arvndlr/air-quality-app/.codex-remote-attachments/019ea0f2-240d-7be0-9d85-20d7ddeb425b/a20465ec-c1ca-47cc-bcd7-c16e4f965e72/1-Photo-1.jpg

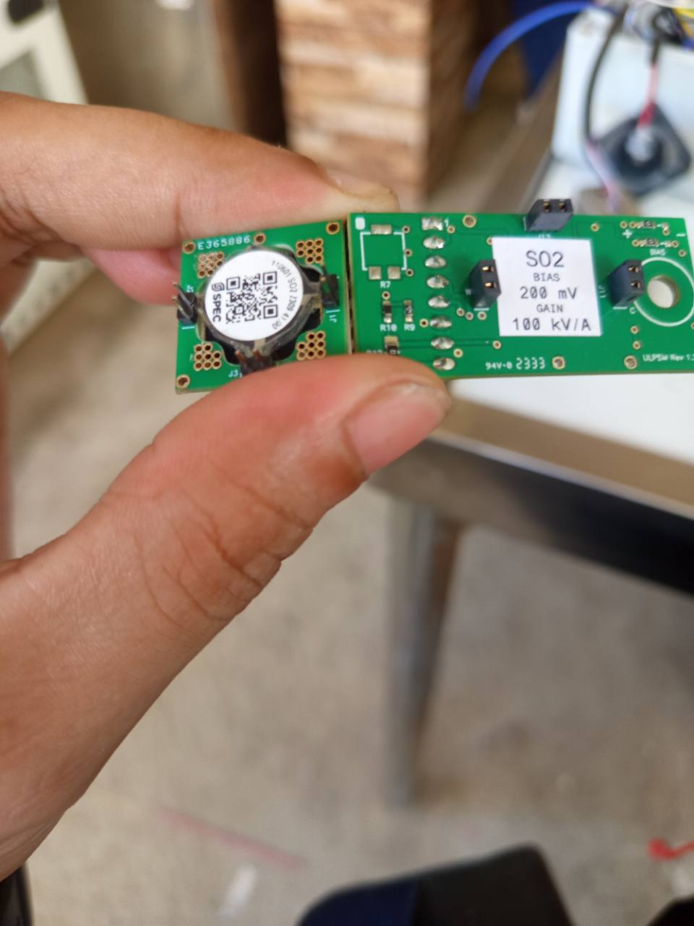
.codex-remote-attachments/019ea0f2-240d-7be0-9d85-20d7ddeb425b/a20465ec-c1ca-47cc-bcd7-c16e4f965e72/1-Photo-1.jpg
