arvndlr/air-quality-app/docs/app-flowchart-a4.pdf

# Air Quality App Flowchart

Single-page A4 layout based on the diagrams defined in docs/app-flowchart.md. | A4 Landscape

# 1. End-to-End System Flow

No | Yes
No | Yes

## ESP32 boots

## Initialize sensors and hardware BME680, SCD40, PM, SO2, MiCS-6814, battery relay

## Connect Wi-Fi and sync time

## Warm up and calibrate sensors MiCS baseline, SO2 warmup/baseline

## Main loop every 10s

## Read sensors and system state

## Compute derived values VOC index, SO2 ppb, CO/NO2/NH3 estimates

## Build telemetry JSON payload

## Wi-Fi connected?

Store payload in offline ring buffer | Flush buffered payloads first

## POST /api/v1/ingest with X-API-Key

## API validates body with Zod

## Find device by externalId

## Device found and API key valid?

Return 404 or 401 | Create Measurement row in PostgreSQL via Prisma

## Compute AQI from PM2.5, PM10, CO, NO2, SO2

## Publish measurement over WebSocket hub

Return 201 OK | Dashboard WebSocket clients /ws?deviceId=... or all

## Historical data available to REST endpoints

# 2. Web App Navigation and Data Flow

/

/admin/login

No | Yes

/admin/*

No | Yes

User opens web app

Route

Landing Page

Admin Login link

Admin Login

Valid email and password
length?
Show client-side error | Save admin session in sessionStorage

Redirect to requested /admin route

RequireAdminAuth

Session exists?

AdminLayout + Sidebar

AQI Dashboard | Sensor Nodes | Pollutant Info | Transmission History | Admin Reports | Placeholder pages FAQs, About, Terms, Settings
listDevices | getLatest for selected device
getSeries for selected metric/range | Open WebSocket for selected device

On live measurement message update latest reading and AQI card

listDevices

getLatest for each device

Static AQI and pollutant guidance content

listDevices | getTransmissionHistory device/range/status/page filters
listDevices | getTransmissionHistory
for report window
getLatest for selected/all devices | window.print for printable report

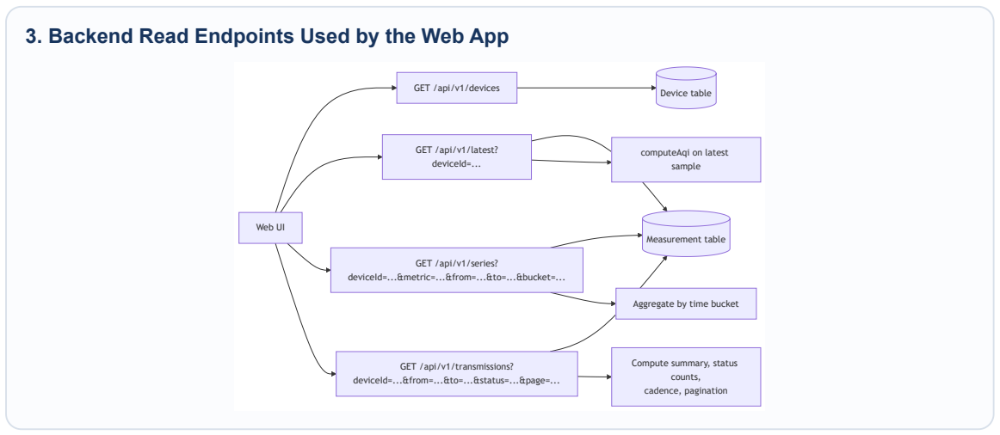
[picture p2: figure]
Web UI; GET /api/v1/devices; GET /api/v1/latest? deviceId=...; Device table; Measurement table; computeAqi on latest sample; Aggregate by time bucket; Compute summary, status counts, cadence, pagination

# 3. Backend Read Endpoints Used by the Web App

GET /api/v1/series? deviceId=...&metric=...&from=...&to=...&bucket=...

GET /api/v1/transmissions? deviceId=...&from=...&to=...&status=...&page=...
