arvndlr/air-quality-app/docs/app-flowchart-reference-style.docx

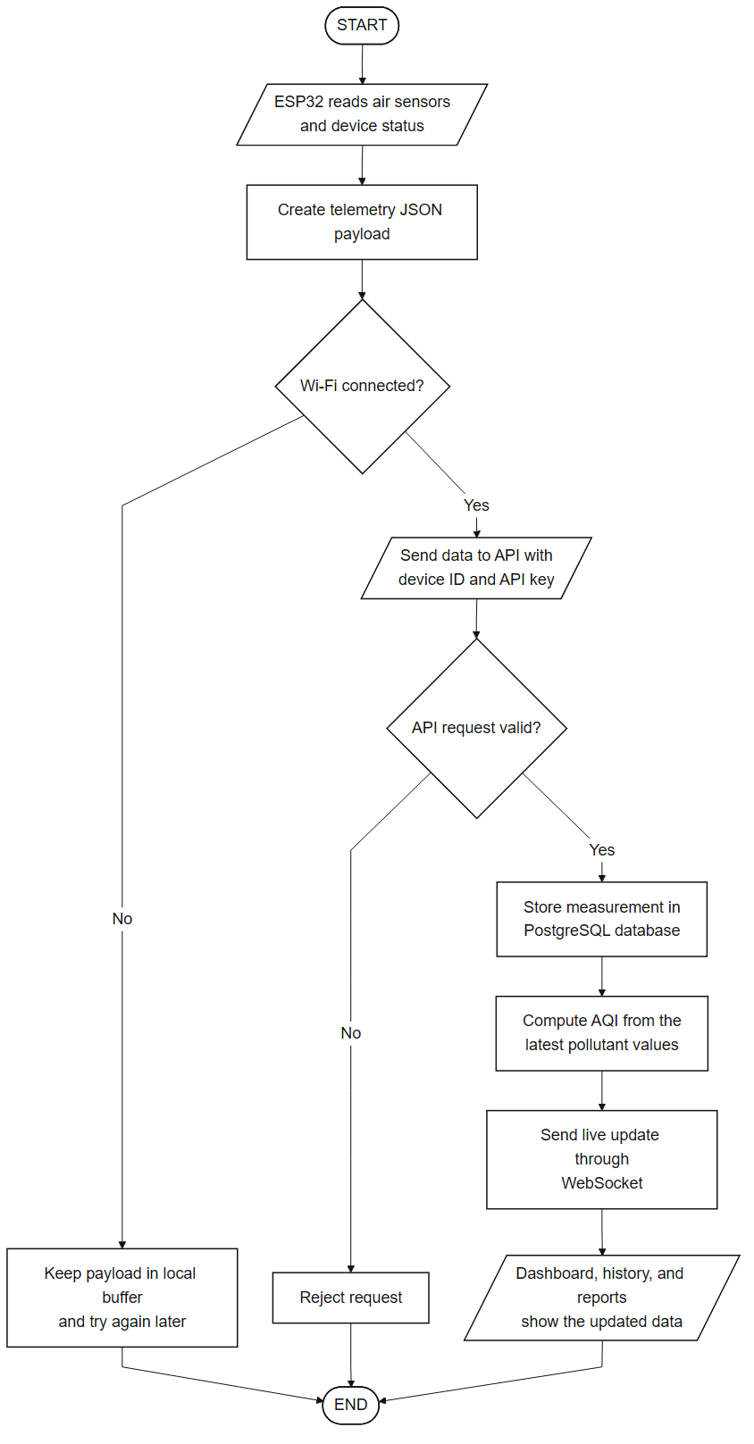
[picture p3: figure]
