arvndlr/air-quality-app/docs/app-flowchart-a4.jpg

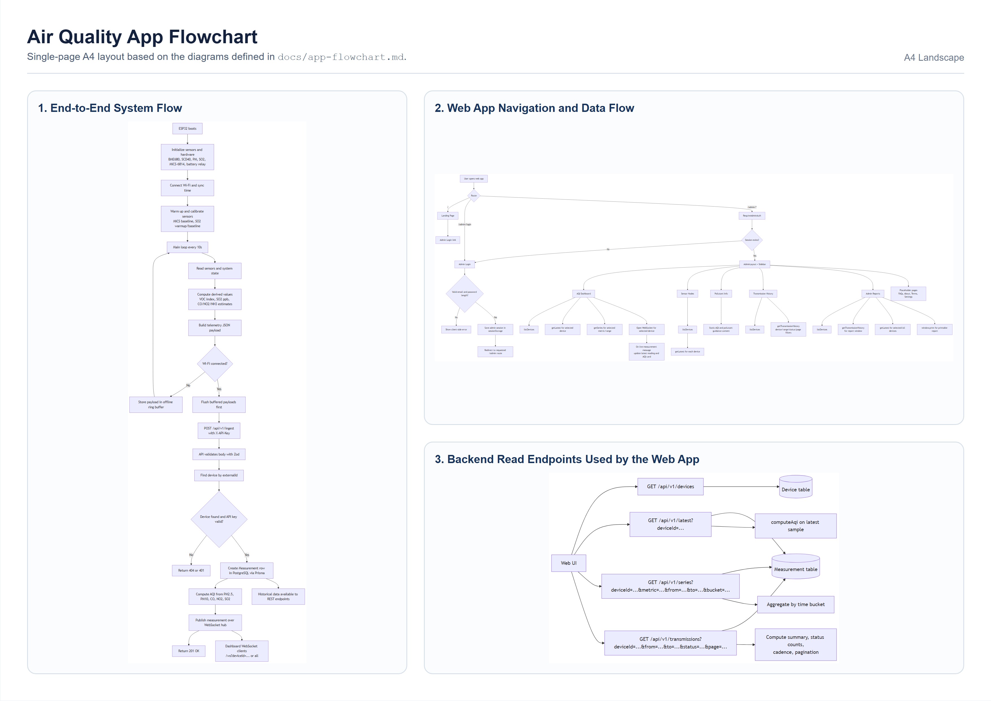
docs/app-flowchart-a4.jpg
