arvndlr/air-quality-app/docs/app-flowchart-backend-a4.jpg

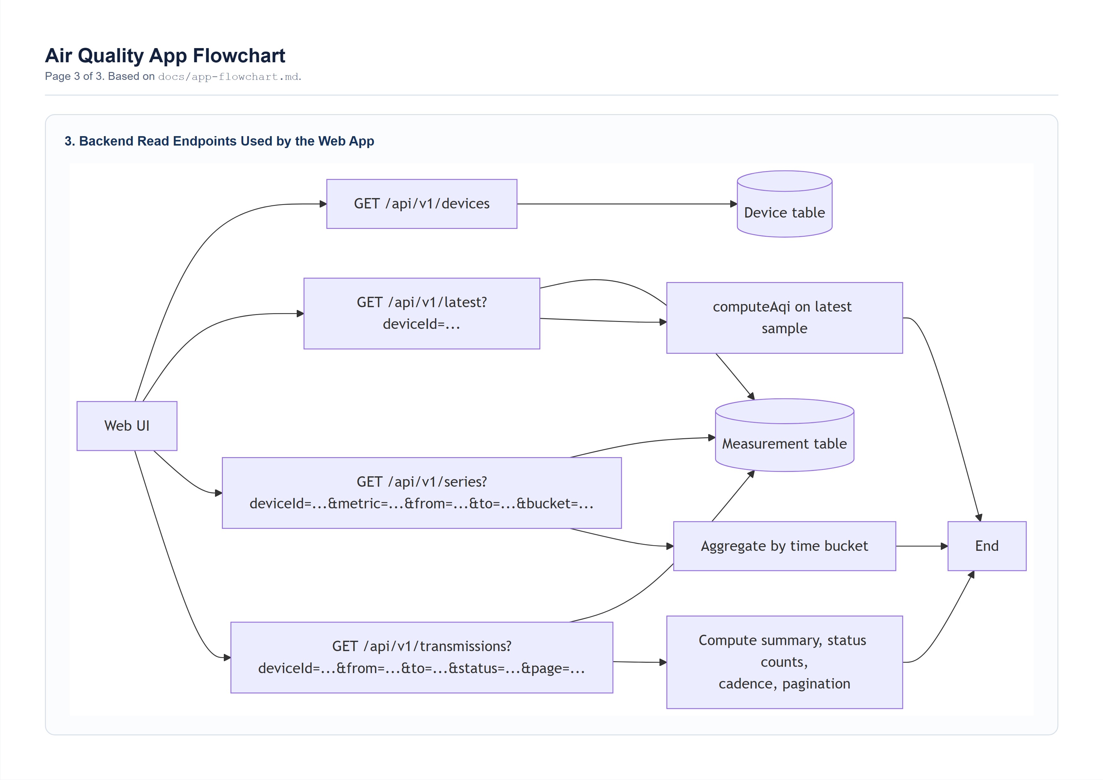
docs/app-flowchart-backend-a4.jpg
