arvndlr/air-quality-app/docs/app-flowchart-backend.jpg

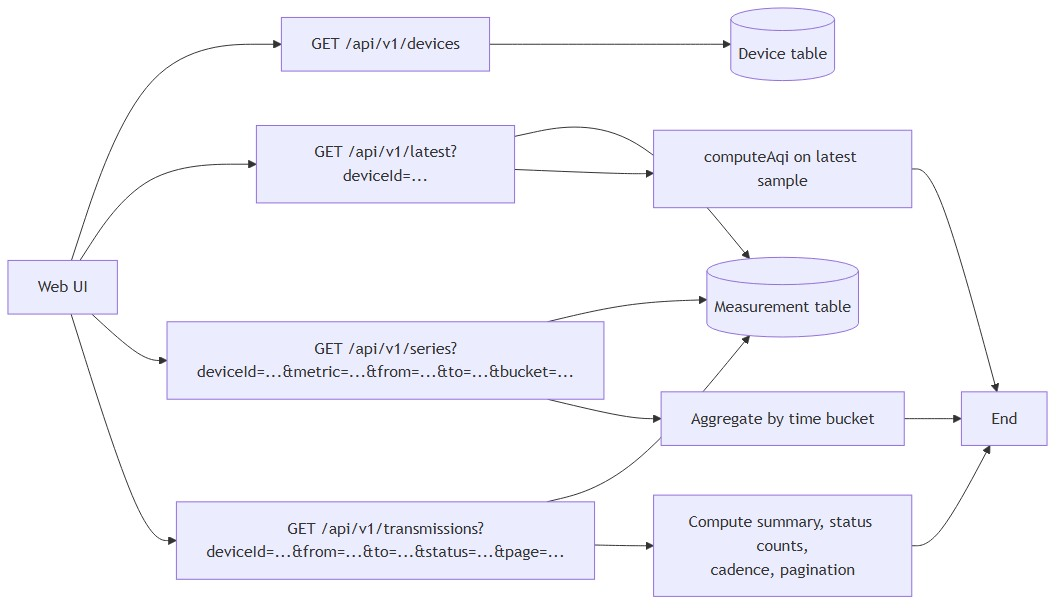
docs/app-flowchart-backend.jpg
