arvndlr/air-quality-app/docs/app-flowchart-simple.jpg

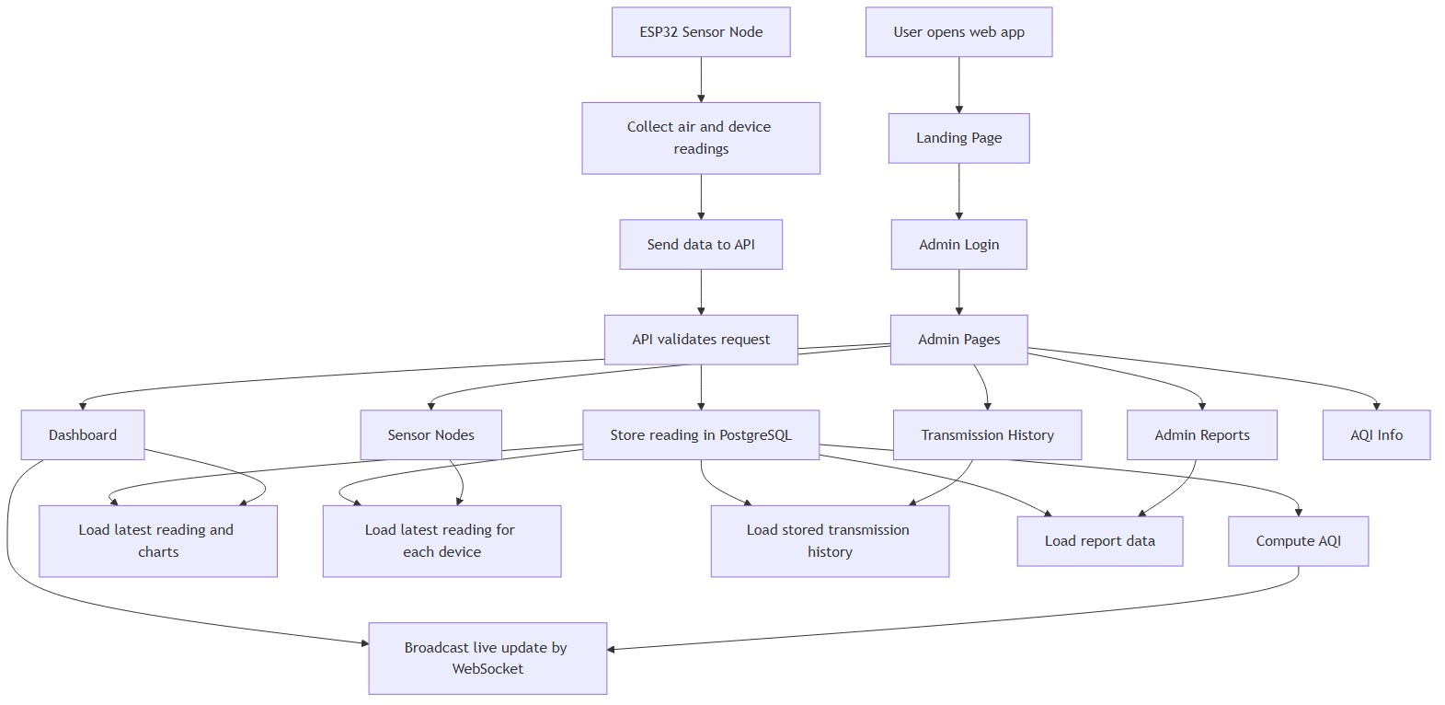
docs/app-flowchart-simple.jpg
