arvndlr/air-quality-app/docs/app-flowchart-system-a4.jpg

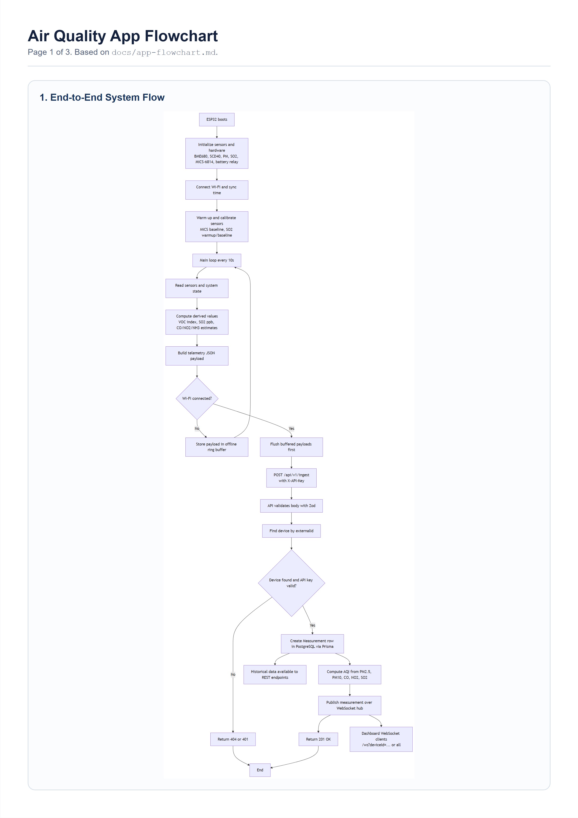
docs/app-flowchart-system-a4.jpg
