arvndlr/air-quality-app/docs/app-flowchart-system.jpg

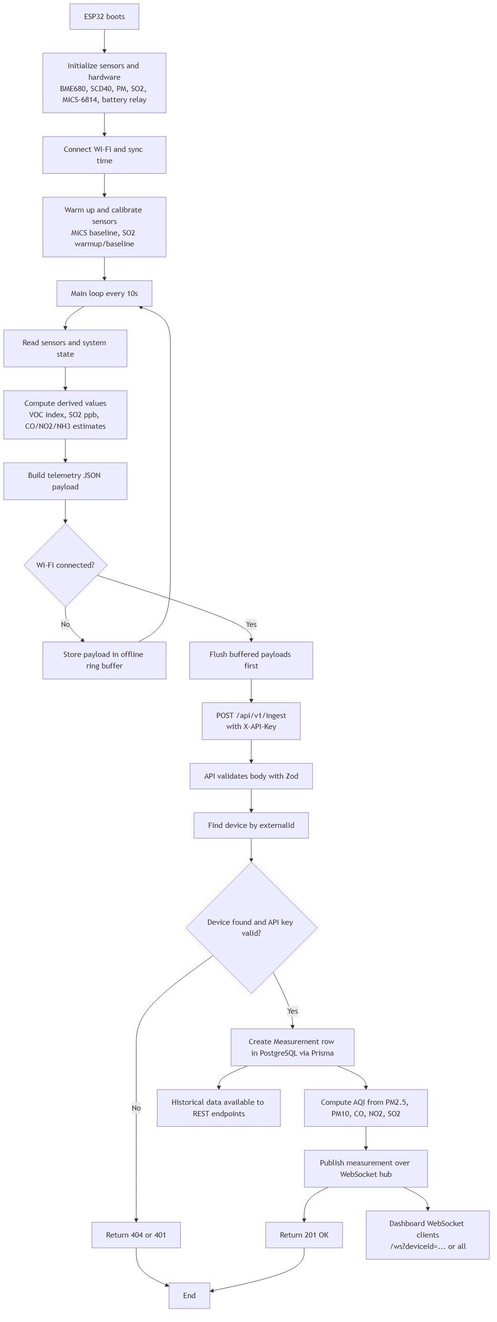
docs/app-flowchart-system.jpg
