arvndlr/air-quality-app/docs/app-flowchart-web-a4.jpg

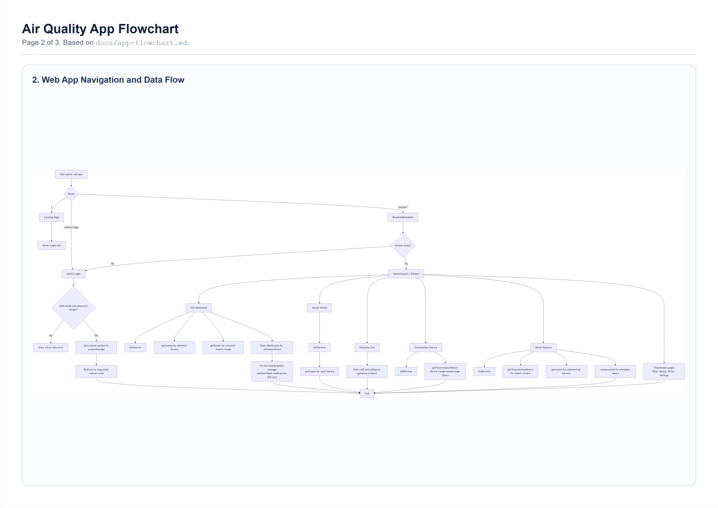
docs/app-flowchart-web-a4.jpg
