arvndlr/air-quality-app/docs/app-flowchart-web.jpg

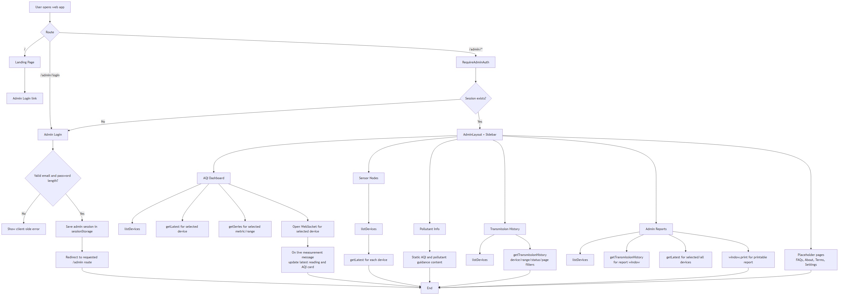
docs/app-flowchart-web.jpg
