arvndlr/air-quality-app/docs/app-flowchart.jpg

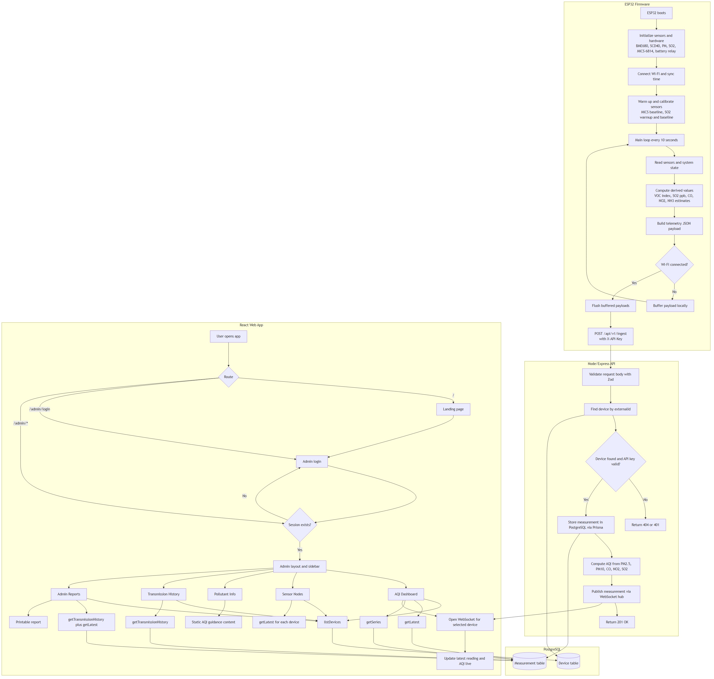
docs/app-flowchart.jpg
