arvndlr/air-quality-app/docs/app-flowchart-backend-a4.pdf

### Air Quality App Flowchart

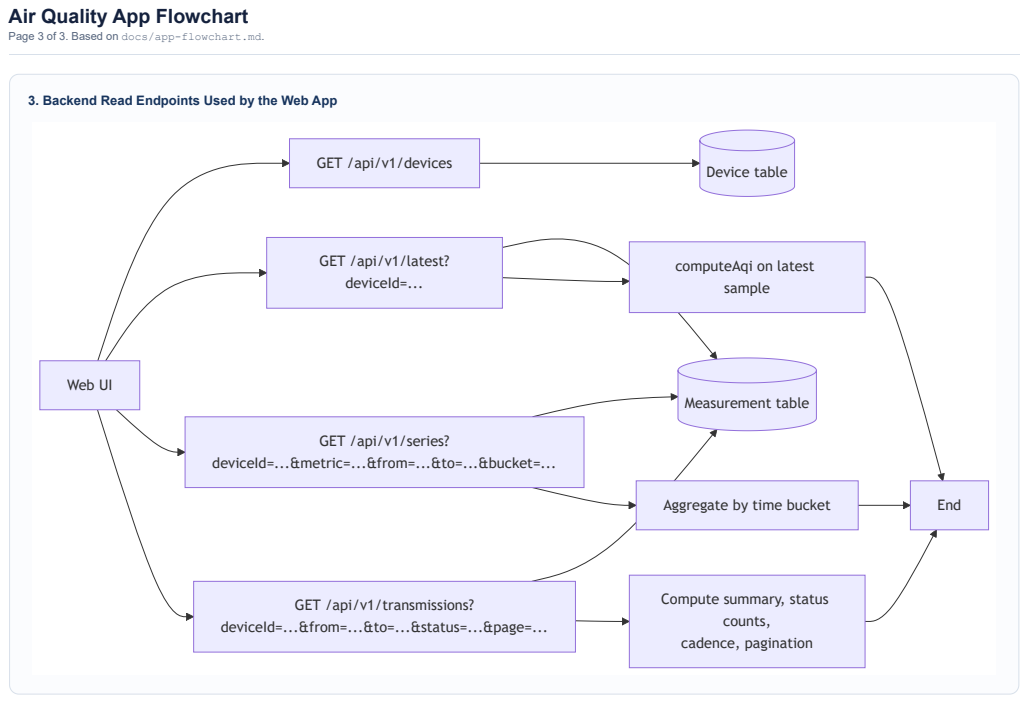
[picture p13: page 1]
Web UI; Device table; Measurement table; counts, cadence, pagination; End

Page 3 of 3. Based on docs/app-flowchart.md.

3. Backend Read Endpoints Used by the Web App

GET /api/v1/devices

GET /api/v1/latest?
deviceId=...

computeAqi on latest
sample

GET /api/v1/series?

deviceId=...&metric=...&from=...&to=...&bucket=...

Aggregate by time bucket

Compute summary, status

GET /api/v1/transmissions?

deviceId=...&from=...&to=...&status=...&page=...
