arvndlr/air-quality-app/docs/app-flowchart-system-a4.pdf

# Air Quality App Flowchart

Page 1 of 3. Based on docs/app-flowchart.md.

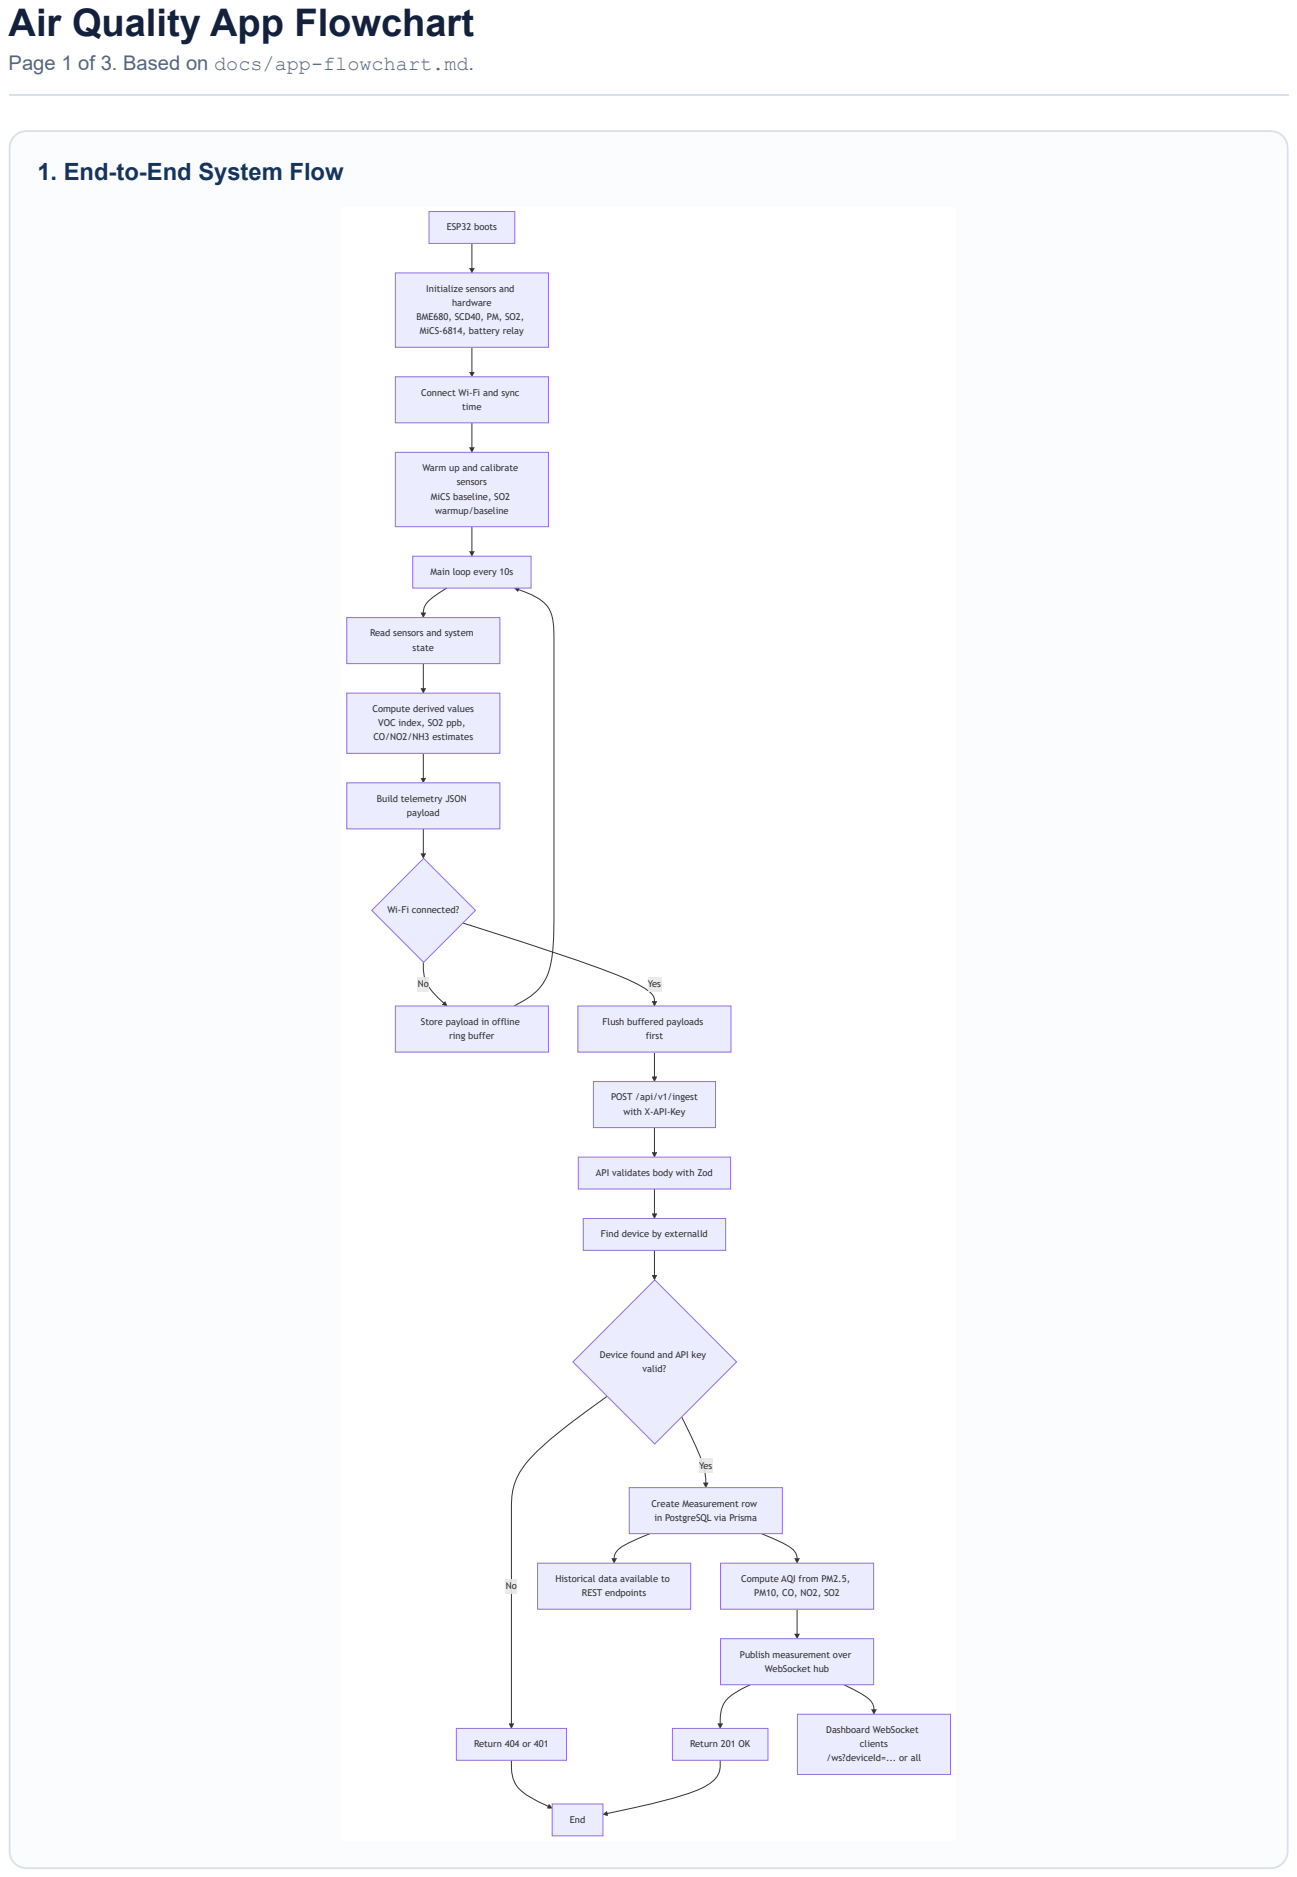
[picture p14: page 1]
Yes; ESP32 boots; time; state; first; valid?; Return 404 or 401; Return 201 OK; End

1. End-to-End System Flow

Initialize sensors and hardware BME680, SCD40, PM, SO2, MiCS-6814, battery relay

Connect Wi-Fi and sync

Warm up and calibrate
sensors MiCS baseline, SO2 warmup/baseline

Main loop every 10s

Read sensors and system

Compute derived values VOC index, SO2 ppb, CO/NO2/NH3 estimates

Build telemetry JSON payload

Wi-Fi connected?

Store payload in offline
ring buffer

Flush buffered payloads

POST /api/v1/ingest with X-API-Key

API validates body with Zod

Find device by externalId

Device found and API key

Create Measurement row
in PostgreSQL via Prisma

Historical data available to REST endpoints

Compute AQI from PM2.5, PM10, CO, NO2, SO2

Publish measurement over WebSocket hub

Dashboard WebSocket
clients /ws?deviceId=... or all
