arvndlr/air-quality-app/docs/app-flowchart-web-a4.pdf

# Air Quality App Flowchart

Page 2 of 3. Based on docs/app-flowchart.md.

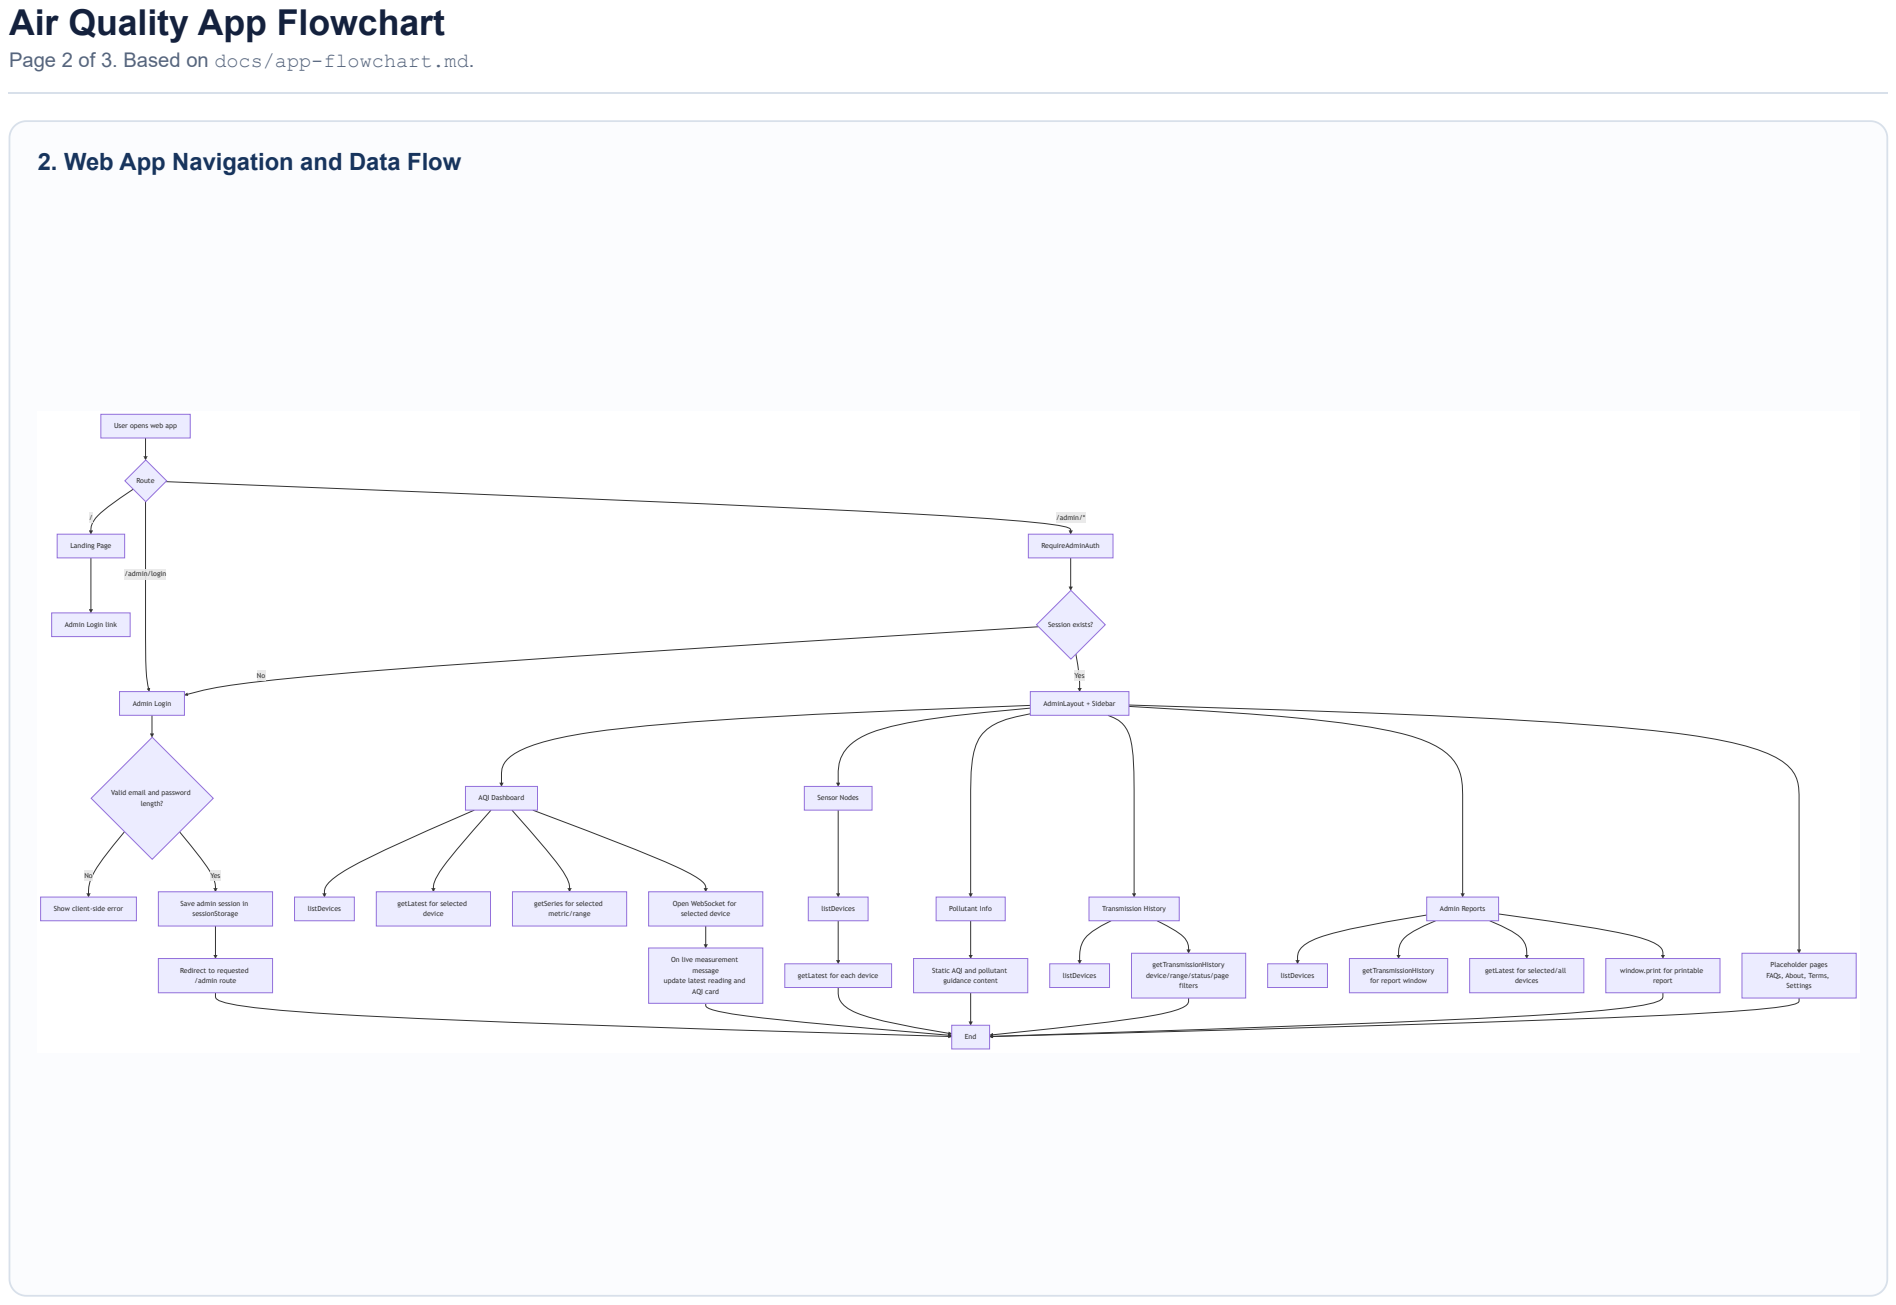
[picture p15: page 1]
/admin/login; Yes; /admin/*; Route; Landing Page; Admin Login; length?; Show client-side error; Save admin session in sessionStorage; RequireAdminAuth; Session exists?; AdminLayout + Sidebar; AQI Dashboard; Sensor Nodes; Pollutant Info; Transmission History; Admin Reports; listDevices; getLatest for selected device; getSeries for selected metric/range; Open WebSocket for selected device; filters; getTransmissionHistory; getLatest for selected/all devices; window.print for printable report; End

2. Web App Navigation and Data Flow

User opens web app

Admin Login link

Valid email and password

On live measurement message update latest reading and AQI card

Redirect to requested /admin route

getLatest for each device

Static AQI and pollutant guidance content

getTransmissionHistory device/range/status/page

for report window

Placeholder pages FAQs, About, Terms, Settings
