arvndlr/air-quality-app/(commit log)

2026-05-24 Switch web app to light theme
2026-06-07 Add reporting visuals, docs, and SO2 sensor updates
2026-06-07 Add unified pollutant distribution charts to admin reports
    - Replace individual pollutant charts with combined distribution visualization
    - Add grouped bar chart showing all pollutants by device
    - Add pie chart showing overall pollutant distribution
    - Charts toggle between bar and pie views
    - Includes PM2.5, PM10, SO2, CO, and VOC pollutants
2026-08-11 Link sensor node cards to filtered dashboard view
    Remove unused placeholder routes (FAQs, About Us, Terms, Settings) and
    make sensor node cards navigate to the dashboard pre-filtered by
    device via a deviceId query param, kept in sync with the URL.
2026-09-27 add so2 only esp32 and hover effect
2026-09-29 Support HTTPS ingest URLs in firmware and fix app spec repo URL
    The ESP32's HTTPClient::begin(url) only accepts http:// URLs, so nodes could
    not post to the DigitalOcean deployment, which redirects http to https.
    Use a WiFiClientSecure (setInsecure) when API_URL is https://; plain http://
    for LAN development is unchanged.
    Also replace the placeholder repo URL for the web static site in
    .do/app.yaml.
    [esp32-air-quality.ino]
2026-10-09 Rework MiCS-6814 wiring and calibration; trim SO2-only sketch
    - Move MiCS-6814 to CO=GPIO33, NO2=GPIO34, NH3=GPIO32 (all ADC1) with
    47k/10k/47k load resistors to 3.3V instead of 5V dividers
    - Compute Rs from calibrated ADC millivolts
    - Run warm-up non-blocking from loop(), persist R0 to flash via
    Preferences, and re-calibrate on BOOT button press
    - Remove config block from esp32-so2-only.ino
    [esp32-air-quality.ino, esp32-so2-only.ino]
2026-10-19 Read ULPSM-SO2 through an ADS1115 and restore the SO2-only sketch
    f956d04 cut 138 lines out of the middle of esp32-so2-only.ino (pin and
    UART config, constants, warm-up and baseline state), so it no longer
    compiled. Restore them and move the SO2 front end to an ADS1115:
    - The ESP32 ADC steps in ~0.8 mV (~270 ppb at 3 mV/ppm) and its input
    loads the high-impedance Vref, so field readings jumped between the
    0 and 1000 ppb clamps while Vref drifted ~0.1 V. Read Vgas-Vref
    differentially on ADS1115 A0-A1 at 8 SPS (~7.8 uV/step at gain 16),
    stepping the gain down if the offset clips.
    - Derive mV/ppm from the sensor's labelled sensitivity (nA/ppm) and TIA
    gain instead of a fixed 3 mV/ppm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
2026-10-19 Make MiCS-6814 R0 calibration plausible, per-channel and non-blocking
    On the Public Market node a cold heater produced NO2 R0 = 134 kOhm (the
    datasheet clean-air range is 0.8-20 kOhm), which then made any air read
    as the 10 ppb reference. A CO channel stuck on the ADC rail also caused
    every boot to recalibrate all three channels, and a channel with no
    valid samples was saved as 0, wiping a good NH3 R0.
    - Reject an R0 outside the datasheet clean-air range (widened ~50%),
    both when calibrating and when loading from flash.
    - Require 80% on-scale samples per channel; otherwise keep the previous
    R0 instead of overwriting it.
    - After warm-up, calibrate only channels without a valid R0. BOOT s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
2026-10-19 Read SO2 on the ESP32 ADC with oversampling and flag unstable readings
    Drop the ADS1115 from the SO2-only node and go back to GPIO34/35, with:
    - Oversampling: 9 groups x 64 conversions per pin per reading (was
    9 x 16), averaged as floats so the sub-millivolt part is kept.
    - Baseline over 60 readings (10 min) with a 2 mV span limit (was 12
    readings and a temporary 10 mV relaxation). Samples that fail the input
    checks are skipped instead of counted.
    - mV/ppm from the sensor's labelled sensitivity and TIA gain.
    - New "unstable" status instead of the 0/1000 ppb clamps: a calibrated
    reading is flagged when Vgas or Vref sits at an ADC rail (floating or
    loose pin, as seen on Public Marke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
